gingerologist/esp32-c3-test/doc/klc.md

# Footprint

- F.SilkS & B. SilkS
    + refdes 
        * text size 1.00mm
        * thickness 0.15mm
    + line width
        * 0.12mm recommended
        * 0.10mm for high density or
        * 0.15mm for low density design allowed
    + clearance
        * at lease line width or pad mask expansion
        * 0.20mm recommended
    + pin 1 designator visible
+ F.Fab & B.Fab (simplified mechanical outline)
    + line width
        * 0.10mm recommended
        * 0.15mm max
    + bevel 1mm or 25% of package size (smaller one)
    + text size 1.0mm (0.5mm minimal)
    + thickness 15% of text size
    + refdes required (same text size, thickness)
+ F.CrtYd and B. CrtYd (minimal clearance around body and pads)
    + line width 0.05mm
    + use 0.01mm grid
    + clearance 
        * 0.25mm
        * 0.15mm for components smaller than 0603
        * 0.5mm for connector, canned caps, crystals
        * 1.0mm for BGA
