gingerologist/esp32-c3-test/3d/1050170001.stp

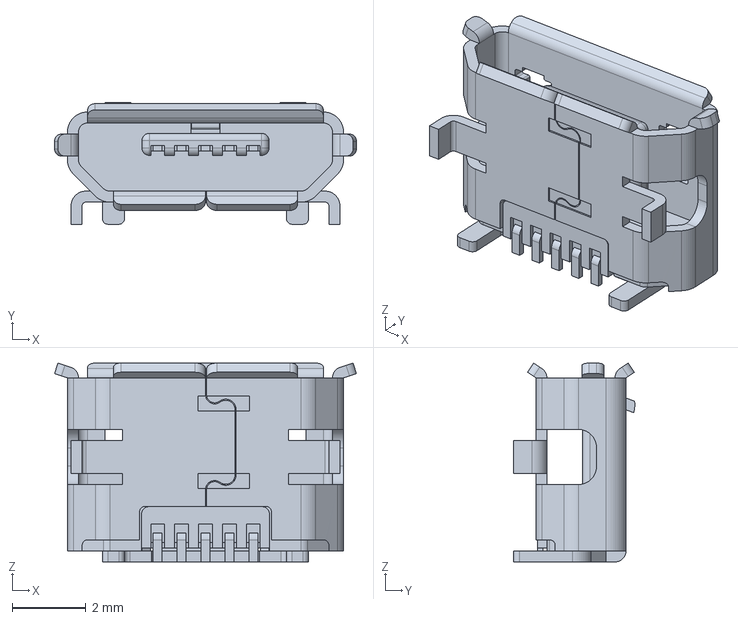
[picture p3: CAD file, 2021-11-08]
3d/1050170001.stp
8.20 x 3.30 x 5.40 mm
