gingerologist/esp32-c3-test/manufacturing/esp32-c3-test.pdf

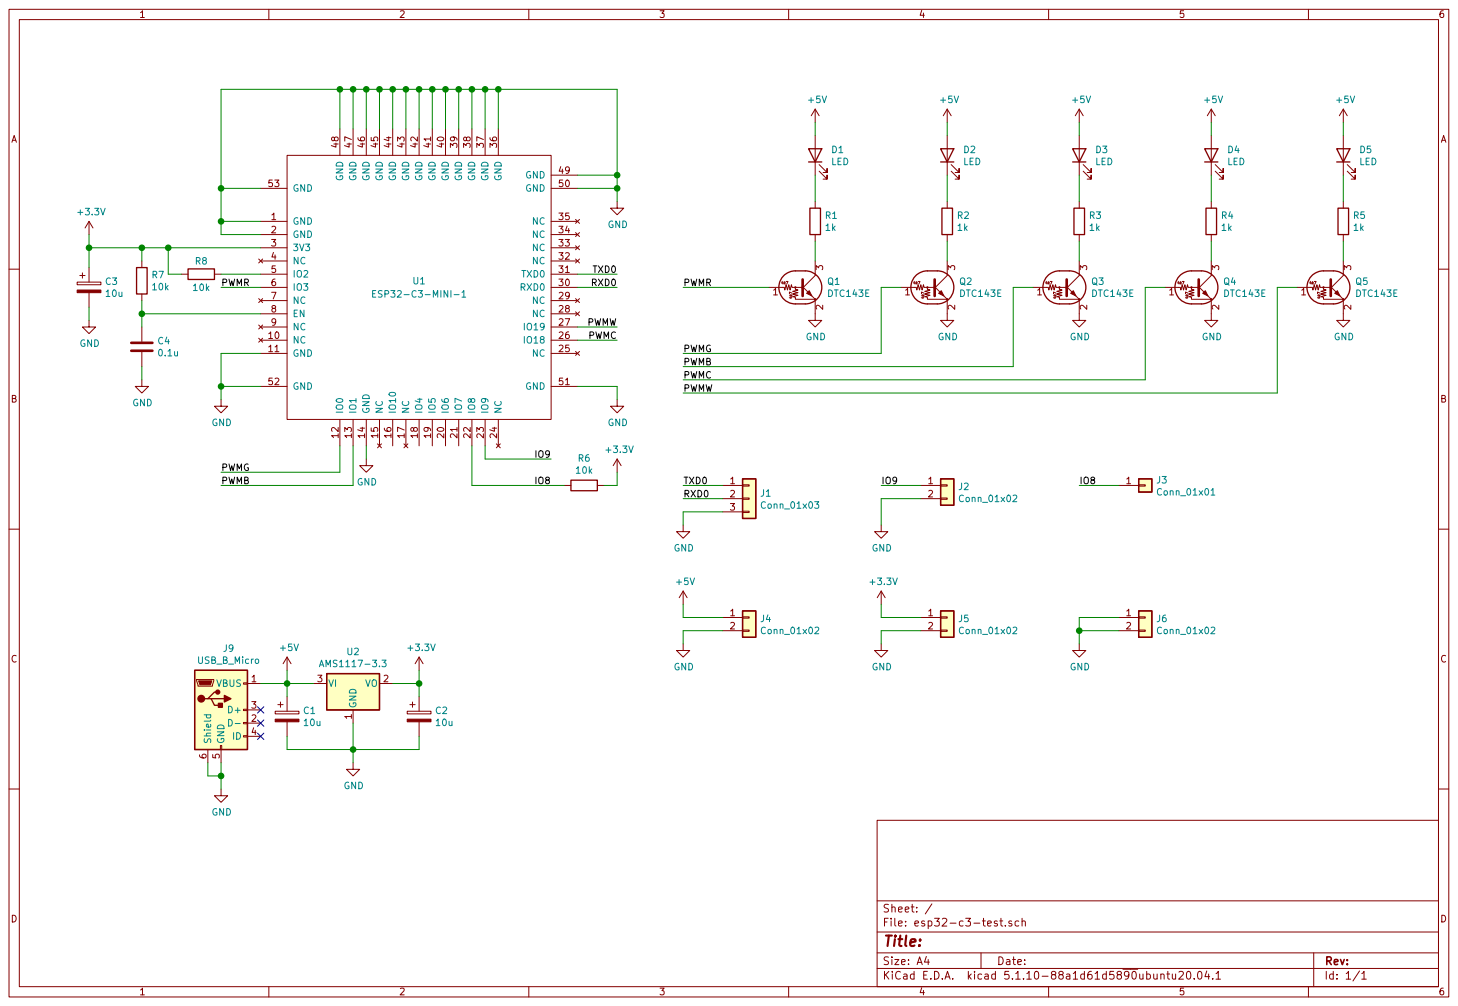
[picture p7: page 1]
