gingerologist/esp32-c3-test/esp32-c3-test.kicad_pcb

## KiCad design esp32-c3-test.kicad_pcb (2021-11-23)

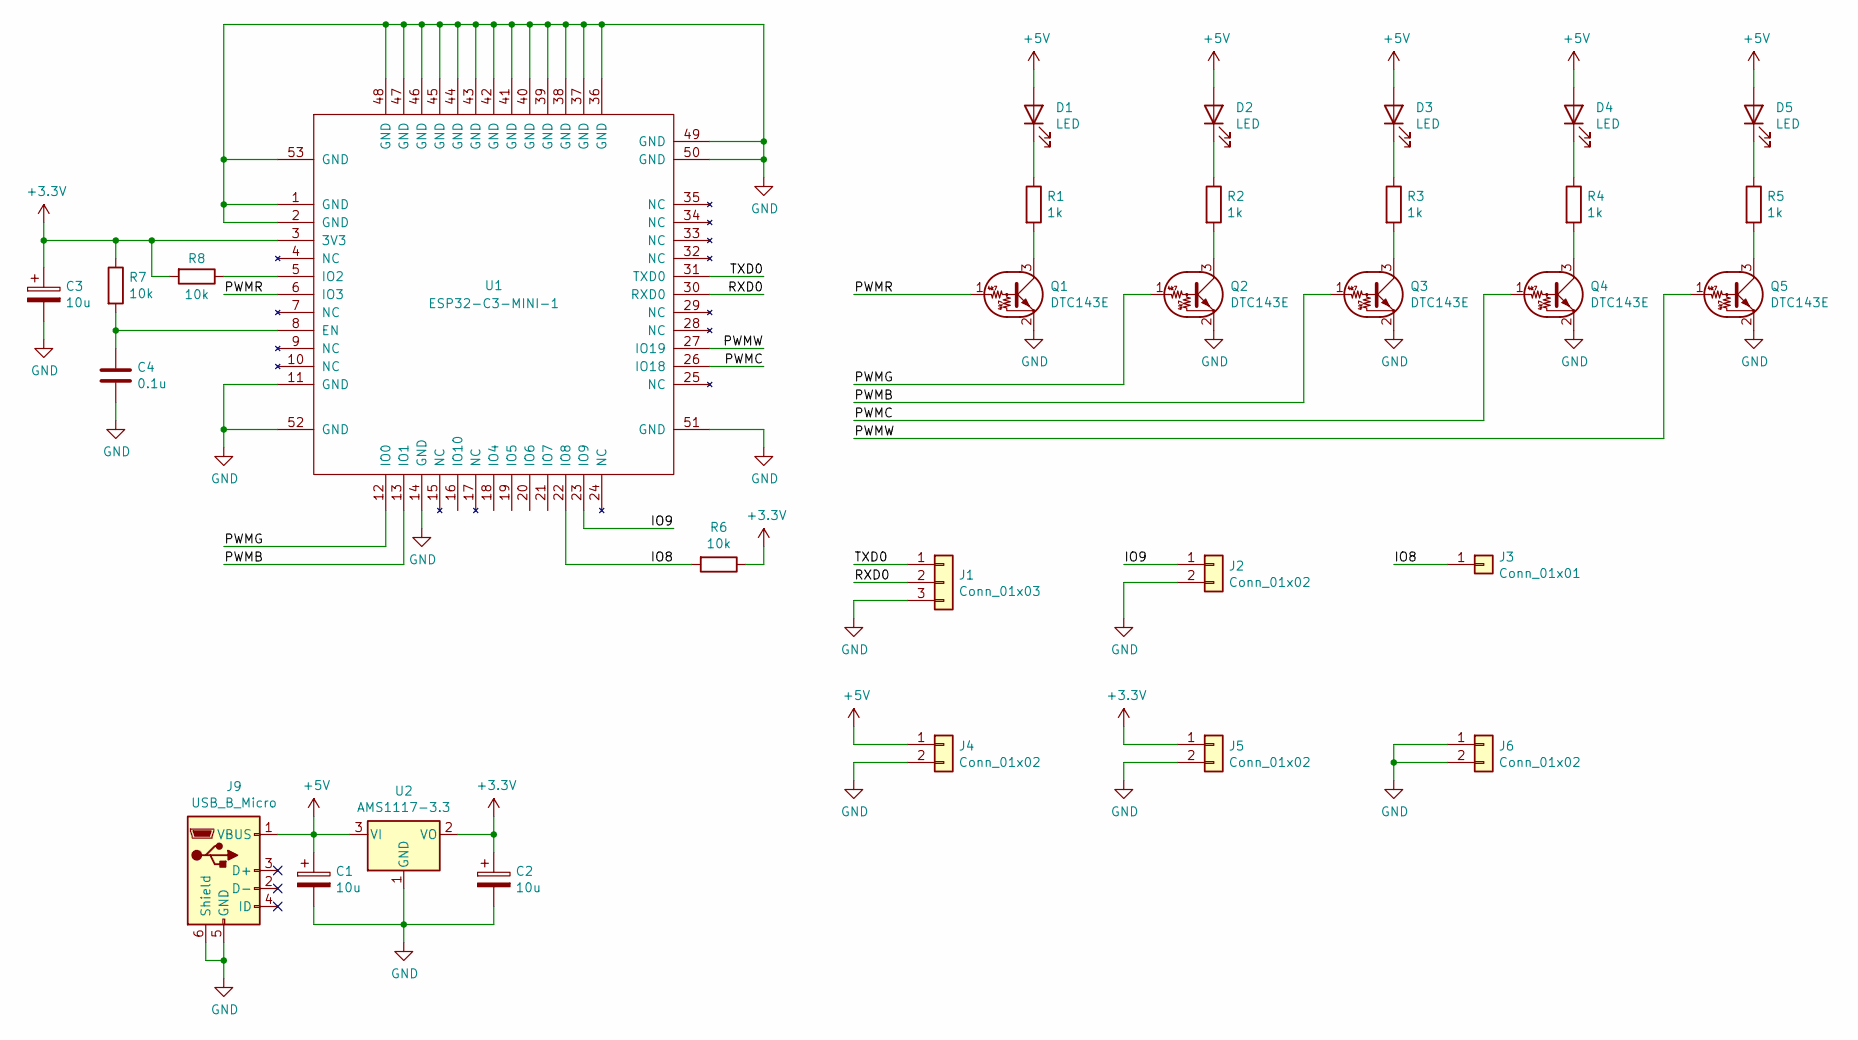
[picture p8: schematic esp32-c3-test.sch]

Parts:
C1, C2, C3: 10u; CP_EIA-3528-21_Kemet-B_Pad1.50x2.35mm_HandSolder
C4: 0.1u; C_0603_1608Metric_Pad1.08x0.95mm_HandSolder
D1, D2, D3, D4, D5: LED; LED_0805_2012Metric_Castellated
J1: Conn_01x03; PinHeader_1x03_P2.54mm_Vert
J2, J4, J5, J6: Conn_01x02; PinHeader_1x02_P2.54mm_Vert
J3: Conn_01x01; PinHeader_1x01_P2.54mm_Vertical
J9: USB_B_Micro; USB_Micro-B_Molex-105017-0001
Q1, Q2, Q3, Q4, Q5: DTC143E; SOT-23
R1, R2, R3, R4, R5: 1k; R_0603_1608Metric_Pad0.98x0.95mm_HandSolder
R6, R7, R8: 10k; R_0603_1608Metric_Pad0.98x0.95mm_HandSolder
U1: ESP32-C3-MINI-1
U2: AMS1117-3.3; SOT-223-3_TabPin2

Connections:
+3V3: C2.1, C3.1, J5.1, R6.1, R7.1, R8.2, U1.3 (3V3), U2.2 (VO)
+5V: C1.1, D1.2 (A), D2.2 (A), D3.2 (A), D4.2 (A), D5.2 (A), J4.1, J9.1 (VBUS), U2.3 (VI)
/IO8: J3.1, R6.2, U1.22 (IO8)
/IO9: J2.1, U1.23 (IO9)
/PWMB: Q3.1 (B), U1.13 (IO1)
/PWMC: Q4.1 (B), U1.26 (IO18)
/PWMG: Q2.1 (B), U1.12 (IO0)
/PWMR: Q1.1 (B), U1.6 (IO3)
/PWMW: Q5.1 (B), U1.27 (IO19)
/RXD0: J1.2, U1.30 (RXD0)
/TXD0: J1.1, U1.31 (TXD0)
GND: C1.2, C2.2, C3.2, C4.2, J1.3, J2.2, J4.2, J5.2, J6.1, J6.2, J9.5 (GND), J9.6 (Shield), Q1.2 (E), Q2.2 (E), Q3.2 (E), Q4.2 (E), Q5.2 (E), U1.1 (GND), U1.2 (GND), U1.11 (GND), U1.14 (GND), U1.36 (GND), U1.37 (GND), U1.38 (GND), U1.39 (GND), U1.40 (GND), U1.41 (GND), U1.42 (GND), U1.43 (GND), U1.44 (GND), U1.45 (GND), U1.46 (GND), U1.47 (GND), U1.48 (GND), U1.49 (GND), U1.50 (GND), U1.51 (GND), U1.52 (GND), U1.53 (GND), U2.1 (GND)
unnamed: C4.1, R7.2, U1.8 (EN)
unnamed: D1.1 (K), R1.1
unnamed: D2.1 (K), R2.1
unnamed: D3.1 (K), R3.1
unnamed: D4.1 (K), R4.1
unnamed: D5.1 (K), R5.1
unnamed: Q1.3 (C), R1.2
unnamed: Q2.3 (C), R2.2
unnamed: Q3.3 (C), R3.2
unnamed: Q4.3 (C), R4.2
unnamed: Q5.3 (C), R5.2
unnamed: R8.1, U1.5 (IO2)

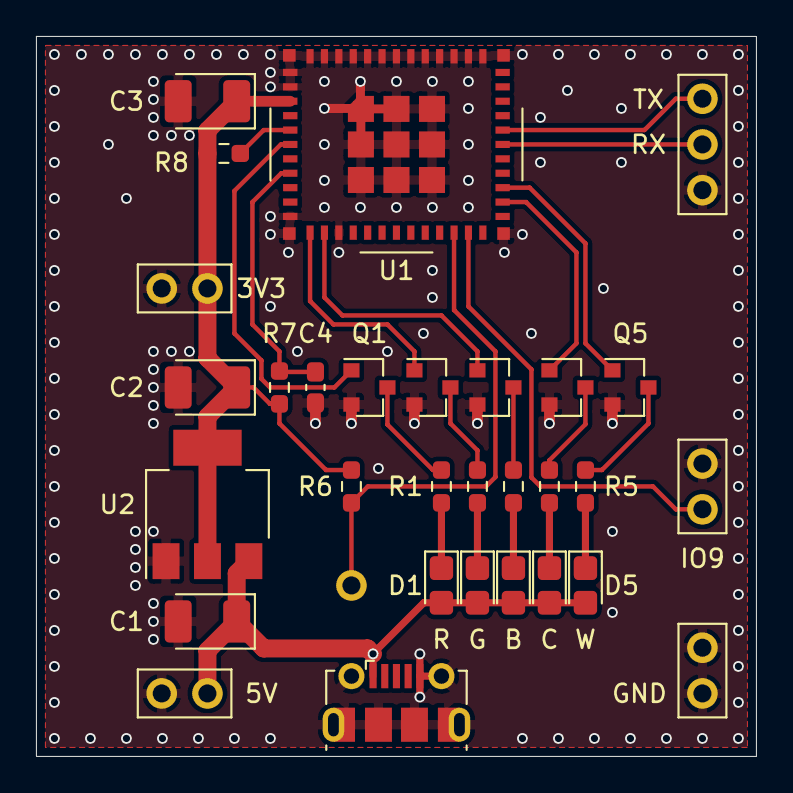
[picture p9: board esp32-c3-test.kicad_pcb from above]

Board: 2 copper layers, 40.0 x 40.0 mm, 31 parts (0 on the bottom side), 24 nets.
