gingerologist/esp32-c3-test/(commit log)

2021-11-08 almost ok
    [1050170001.stp, esp32-c3-test.kicad_pcb, esp32-c3-test.sch]
2021-11-08 1. change c5 to c4 2. modify silkscreen of esp32-c3-mini-1 footprint to avoid via 3. move a few vias
    [esp32-c3-test.kicad_pcb, esp32-c3-test.sch]
2021-11-08 update copper fill and generate manufacturing files.
    [esp32-c3-test-B_Cu.gbl, esp32-c3-test-B_Mask.gbs, esp32-c3-test-Edge_Cuts.gm1, esp32-c3-test-F_Cu.gtl, esp32-c3-test-F_Mask.gts, esp32-c3-test-F_Paste.gtp, esp32-c3-test-F_SilkS.gto, esp32-c3-test-NPTH-drl_map.gbr]
2021-11-08 add readme and schematic in pdf format
2021-11-22 export position file for smt
    ref: http://club.szlcsc.com/article/auther_2386_1_223282.html
    [esp32-c3-test.kicad_pcb]
2021-11-22 1. unignore .csv file 2. add position file in csv format
    [esp32-c3-test.csv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]
2021-11-23 1. modify esp32-c3-mini-1 module footprint, marked as smd 2. update pcb file 3. update exported position file
    [esp32-c3-test.kicad_pcb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]
