gingerologist/esp32-c3-test/(notices)

Notices in the files:
3d/1050170001.stp:
FILE_NAME( 'C:/Users/KMIROS~1/AppData/Local/Temp/psolqas_11320_64.stp', '2020-05-05T18:24:39', ( 'License CC BY-ND 4.0' ), ( 'CADENAS' ), ' ', 'PARTsolutions', ' ' );
